kbinani/how-to-make-angel-ring-1/main.tex

\documentclass{ltjreport}
\usepackage{graphicx}
\usepackage{color}
\usepackage{siunitx}
\usepackage{hyperref}
\usepackage{attachfile2}
\usepackage{xcolor}
\usepackage[top=20mm,bottom=20mm,left=20mm,right=20mm]{geometry}
\usepackage{titlesec}
\usepackage{etoolbox}
\usepackage{chngcntr}
\usepackage[figure]{hypcap}
\usepackage[nogroupskip,section=none]{glossaries}

\makeatletter
\newcommand{\link}[2]{%
	\@ifundefined{r@#1}{%
		\textcolor{red}{#2 (\texttt{\detokenize{#1}})}%
	}{%
		\hyperref[#1]{#2}%
	}%
}
\makeatother

\newcommand{\asin}[1]{%
	\href{https://www.amazon.co.jp/dp/#1}{\texttt{ASIN:#1}}%
}

\renewcommand{\prechaptername}{}
\renewcommand{\postchaptername}{.}

\makeatletter
\patchcmd{\l@chapter}{4zw}{2zw}{}{}
\makeatother

\newcommand{\file}[2]{%
	\leavevmode
	\rlap{\textcolor{violet}{\texttt{#2}}}%
	\textattachfile{./attachment/#1}{\phantom{\texttt{#2}}}%
}

\newcommand{\img}[1]{%
	
}

\NewDocumentCommand{\defgls}{m m O{}}{%
	\newglossaryentry{#1}{name={#1},user1={#2},description={#3}}%
}

\newlength{\qindent}
\settowidth{\qindent}{\bfseries Q.\hspace{1em}}

\NewDocumentCommand{\qa}{+m +m}{%
	\paragraph{Q.}%
	\hangindent=\qindent
	\hangafter=1
	#1\par
	\vspace{-3.25ex}%
	\paragraph{A.}%
	\hangindent=\qindent
	\hangafter=1
	#2\par
}

\setcounter{secnumdepth}{3}
\counterwithout{figure}{chapter}

\defgls{クランプ}{\asin{B0D3TWFQYM}}
\defgls{真空槽}{\asin{B09QKQT76Z}}[BACOENG 製]
\defgls{中敷き}{\asin{B0D8BDKLCK}}
\defgls{エポキシ樹脂}{\asin{B09BJ2F91Y}}[デコレジーナ製「エポキシ樹脂 E384」]
\defgls{秤}{\asin{B072TBYM2K}}[タニタ製「クッキングスケール KJ-212 WH」]
\defgls{シリコーン樹脂マット}{\asin{B07KT39VH3}}
\defgls{攪拌棒}{\asin{B0DCJWFG8K}}
\defgls{プラスチックカップ}{\asin{B08F1Y5GFL}}
\defgls{色素}{\href{https://www.padico.co.jp/products/pigment-liquid/basic-colors/jewel-color-for-uv-and-uv-led-curing-resin-royal-blue/}{メーカー公式商品ページ}}[パジコ製「宝石の雫 ロイヤルブルー」]
\defgls{注射器}{\asin{B0BZ4GRGQX}}
\defgls{注射針(24G)}{\asin{B0CN4RSC4D}}
\defgls{注射針(20G)}{\asin{B0CMV9C128}}
\defgls{MDF 板材}{\asin{B0B6ZY4SFP}}
\defgls{3D プリンター}{\asin{B0F9DXZBW6}}[Creality 製「Ender3 V3 KE」]
\defgls{PLA}{\asin{B0C89KPYP3}}[Creality 製「Ender PLA フィラメント」]
\defgls{シリコーンチューブ}{\asin{B0DD7D93FN}}
\defgls{三叉バルブ}{\asin{B0DRCXKLVQ}}
\defgls{ホースニップル(G 1/4)}{\asin{B003FMS2Y6}}[SK11 製「ホースニップル外ネジ G(PF) 1/4 HG-1209 0200」]
\defgls{シールテープ}{\asin{B00VDTZMJQ}}[SK11 製「シールテープ SST-0805」]
\defgls{シリコーン樹脂}{\asin{B083QQJ2JS}}[旭化成ワッカーシリコーン製「ELASTOSIL(R) M8012」]
\defgls{両面テープ}{\asin{B07NPXBD1X}}[KAWAGUCHI 製「水に強い布用両面テープ」]
\defgls{マスキングテープ}{\asin{B009LALTUA}}[3M 製「マスキングテープ 243J Plus」]
\defgls{攪拌用ヘラ}{\asin{B019BWMXX4}}[貝印製「パレットナイフ」]
\defgls{シリコーンブロアー}{\asin{B0932Z7646}}[ハクバ製「シリコンブロアーポータブル 02 ブラック」]
\defgls{プラスチック板}{\asin{B00777S0A6}}[ツクワ製]
\defgls{パテ}{\asin{B000R9N5VU}}[タミヤ製「タミヤパテ(ホワイト) 87059」]
\defgls{レジンプリンター}{\asin{B0DT99F529}}[ELEGOO 製「Saturn 4 Ultra 16K」]
\defgls{レジン}{\asin{B0C61HMFMR}}[NOVA3D 製「水洗い高透明レジン」]
\defgls{コンパウンド}{\asin{B0CJJDTVS9}}[タミヤ製「タミヤコンパウンド 仕上げ目 87070」]
\defgls{バフ}{\asin{B0FPLD3NJ4}}
\defgls{ミニリューター}{\asin{B074WCD7VR}}[Dremel 製「ペン型ミニルーター FINO」]
\defgls{防毒マスク}{\asin{B0BJVBKJ6S}}[重松製作所製「取替え式防じんマスク・直結式小型防毒マスク」]
\defgls{有機ガス用吸収缶}{\asin{B072X8CW2M}}[重松製作所製「防じん機能付き吸収缶」]
\makenoidxglossaries

\newglossarystyle{items}{%
	\renewenvironment{theglossary}
		{\begin{longtable}[l]{lll}}
		{\hline\end{longtable}}%
	\renewcommand*{\glossaryheader}{%
		\hline
		品名 & 入手先 & メーカー等 \\ \hline
		\endhead
	}%
	\renewcommand*{\glsgroupheading}[1]{}%
	\renewcommand*{\glossentry}[2]{%
		\glstarget{##1}{\glossentryname{##1}} &
		\glsentryuseri{##1} &
		\glossentrydesc{##1} \\
	}%
	\renewcommand*{\glsgroupskip}{}%
}

\title{天使の輪っかのつくり方1 \\ [20mm]
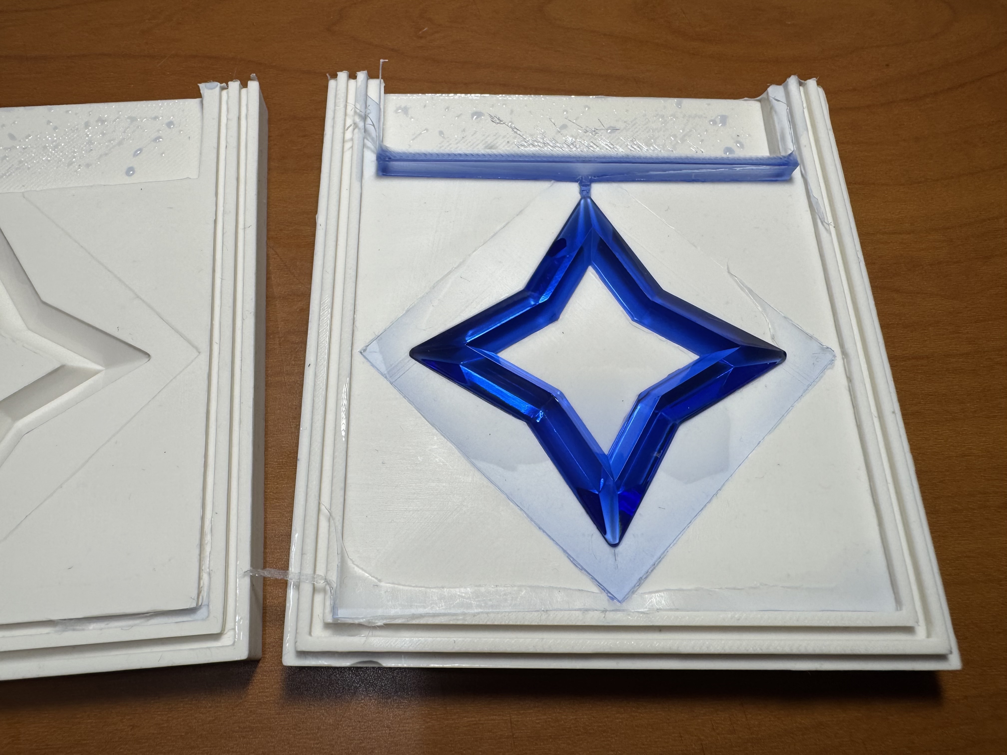
[picture p1: img/cover.jpeg]
 \\ [5mm]}
\author{kbinani}
\date{\today \\
\texttt{rev.2} \\
[2em]
\small 天使の輪っかのつくり方1 © 2026 by kbinani is licensed under CC BY-NC 4.0.
\\
To view a copy of this license, visit \href{https://creativecommons.org/licenses/by-nc/4.0/}{https://creativecommons.org/licenses/by-nc/4.0/}
\\
}

\hypersetup{ %
	colorlinks=true, %
	linkcolor=blue, %
	urlcolor=blue, %
	setpagesize=false, %
	bookmarks=true, %
	bookmarksdepth=tocdepth, %
	bookmarksnumbered=true %
}

\begin{document}
\maketitle

\chapter*{免責事項}

本冊子は著者の製作事例を紹介するものであり、手順の安全性、再現性および完成品の品質を保証するものではありません。

作業に際しては、使用する材料・機器の取扱説明書等を確認し、適切な安全対策を講じてください。

本冊子および添付データの利用によって生じた事故や損害について、著者は一切の責任を負いません。

\tableofcontents

\chapter{はじめに}

\noindent\textbf{本冊子について}\par
\vspace{0.5\baselineskip}
本冊子は、BOOTH に出品した「\href{https://kbinani.booth.pm/items/8443733}{(非公式)天音かなた・ミニチュア「天使の輪っか」エポキシ樹脂製・約5cm}」の製作手順を記したものである。
量産のための手順のみとし、開発過程は省略した。
「製作」の章は、最終仕上げを先頭に、製作のための治具製作などが後半となるよう、およそ時系列逆順に記した。
「Q\&A」の章には想定問答を記した。
最後の章には製作に必要な物品リストを掲載した。

\vspace{\baselineskip}

\noindent\textbf{添付ファイルについて}\par
\vspace{0.5\baselineskip}
本冊子の PDF にはファイルを埋め込んである。
紫色のファイル名の文字にはリンクが張ってあり、添付ファイルの取り出しに対応した PDF ビューワで閲覧するとファイルを取得できるようになっている。
Firefox と Acrobat Reader の場合は、どちらも紫色のリンクをダブルクリックすることでファイルを取得できる。

\chapter{製作}

%%%%%%%%%%%%%%%%%%%%%%%%%%%%%%%%%%%%%%%%%%%%%%%%%%%%%%%%%%%%%%%%%%%%%%%%%%%%%%%%%%
% 脱型と仕上げ
%%%%%%%%%%%%%%%%%%%%%%%%%%%%%%%%%%%%%%%%%%%%%%%%%%%%%%%%%%%%%%%%%%%%%%%%%%%%%%%%%%
\section{脱型と仕上げ}
\gls{エポキシ樹脂}の主剤と硬化剤を混合してから 72 時間以上経過後に脱型する。
\link{ln:runner}{ランナー部}分をカッターナイフで切り、\link{ln:mold}{型}の合わせ面部分に樹脂のはみ出しがあれば除去する。
表紙の図は脱型作業中の造形物の様子である。

%%%%%%%%%%%%%%%%%%%%%%%%%%%%%%%%%%%%%%%%%%%%%%%%%%%%%%%%%%%%%%%%%%%%%%%%%%%%%%%%%%
% 真空注型
%%%%%%%%%%%%%%%%%%%%%%%%%%%%%%%%%%%%%%%%%%%%%%%%%%%%%%%%%%%%%%%%%%%%%%%%%%%%%%%%%%
\section{真空注型}
\begin{enumerate}
	\item \link{ln:mold}{型}を準備する。
	\begin{enumerate}
		\item 型を清掃する。
		\item \link{ln:mold_spacer}{スペーサー}と\link{ln:mold}{型}を 2 枚の\link{ln:mold_shell}{押さえ板}で挟み、\gls{クランプ}で固定する。
			図\ref{fig:assembled_mold}に組み立てた型一式の様子を示す。
			\begin{figure}[htbp]
				\centering
				\img{./img/assembled_mold.jpeg}
				\caption{組み立てた型一式の様子}
				\label{fig:assembled_mold}
			\end{figure}
			\begin{itemize}
				\item 型と押さえ板の組み立て方について。
					\gls{真空槽}に複数の型一式を縦に積む場合に、上下の型一式の間に\gls{中敷き}を敷く。
					図\ref{fig:insole}に中敷きの配置例を示す。
					\begin{figure}[htbp]
						\centering
						\img{./img/insole.jpeg}
						\caption{中敷きを下段の型一式の上に設置した様子}
						\label{fig:insole}
					\end{figure}
					下段に置く型は、型の上面を下にして組み立て作業を行う。
					上段に置く型は下面を下にして組み立て作業を行う。
					中敷きに当たる側の面が揃っていたほうが、中敷きが安定するからである。
				\item クランプの締め付けは程々にする。
					具体的には、組み立てた型を手で持った時、型内部の空洞の容積がほぼ変化しない程度の強さでクランプする。
					型内部の空洞の容積が変化すると\link{ln:boiling_tank}{沸騰槽}と型内部で樹脂の移動が起こり、意図しない気泡の巻き込みが起こりやすくなるからである。
					\link{ln:deforming}{脱泡}の操作が台無しになる。
					またクランプの締め付けが強すぎると、型表面の肌が変形し品質を損なう。
			\end{itemize}
	\end{enumerate}
	\item 真空ポンプを準備する。
	\begin{itemize}
		\item 真空ポンプの取扱説明書に従う。
		\item 特に、オイル量が適切か確認する。
	\end{itemize}
	\item 真空槽を準備する。
	\begin{enumerate}
		\item 空気圧ゲージを準備する。
		\begin{itemize}
			\item 空気圧ゲージの取扱説明書に従う。
			\item オイル封入型の場合内圧を大気圧と一致させる為のプラグが付いているので、忘れずに操作する。
		\end{itemize}
		\item 真空槽の大気側プラグに\link{ln:mold_capillary}{キャピラリ}を取り付ける。
			キャピラリの全てのバルブを全閉にする。
		\item 真空槽の真空ポンプ側プラグと真空ポンプを接続する。
			真空槽の全てのバルブを全閉にする。
	\end{enumerate}
	\item \gls{エポキシ樹脂}を準備する。
	\begin{enumerate}
		\item \gls{秤}を\gls{シリコーン樹脂マット}の上に設置する。
		\item \gls{防毒マスク}に\gls{有機ガス用吸収缶}を取り付け、装備する。
		\item \gls{攪拌棒}と\gls{プラスチックカップ}を清掃する。
		\item プラスチックカップの風袋を量る。
		\item プラスチックカップにエポキシ樹脂の主剤を所定の量量り取る。
		\begin{itemize}
			\item 注型する型の個数 $ \times $ 5.9g の主剤を用いる。
		\end{itemize}
		\item プラスチックカップに\gls{色素}を投入する。
		\begin{itemize}
			\item 主剤 1.0 g に対して 1.0 滴の色素を用いる。
		\end{itemize}
		\item プラスチックカップにエポキシ樹脂の硬化剤を投入する。
		\begin{itemize}
			\item 主剤重量の 40\% の硬化剤を投入する。
		\end{itemize}
		\item 攪拌棒を用いて撹拌する。
		\begin{itemize}
			\item 3 分程度撹拌する。
			\item 撹拌中、気泡が入っても問題ない。
				真空引きしたとき結局発泡するので、撹拌時点で混入する気泡は気にする必要ない。
		\end{itemize}
	\end{enumerate}
	\item 型の沸騰槽に樹脂を入れる。
	\begin{itemize}
		\item \gls{注射器}を用いて 6mL 量る。
	\end{itemize}
	\item 型一式を真空槽に仕込む。
	\begin{itemize}
		\item 上下に 2 段積む場合、上下段の間に中敷きを入れる。
	\end{itemize}
	\item 真空注型を行う。
	\begin{enumerate}
		\item 真空槽の蓋のパッキン部分を清掃し、真空槽に設置する。
		\item 真空ポンプのオイル量と、真空槽の真空ポンプ側バルブが全閉になっている事を確認し、真空ポンプを稼働させる。
		\item 真空槽の真空ポンプ側バルブを全開にする。
		\item 真空槽の蓋を押さえつけて気密する。
		\item ストップウォッチで計時開始する。
		\item 空気圧ゲージがゲージ圧で -1.0 bar となるか、または 3 分経過するまで待機する。
		\item キャピラリの 2 つのバルブがどちらも全閉になっている事を確認し、真空槽の大気側バルブを全開にする。
		\begin{itemize}
			\item この操作はキャピラリ内圧と真空槽内圧を等しくするためのもの。
		\end{itemize}
		\item 真空槽の真空ポンプ側バルブを全閉にする。
		\item 真空ポンプを停止する。
		\item キャピラリの\gls{注射針(24G)}が付いている側のバルブを全開にする。
		\item 空気圧ゲージがゲージ圧で -0.7 bar となるまで待機する。
		\item 真空槽の大気側バルブを全閉にする。
		\item キャピラリの注射針が付いている側のバルブを全閉にする。
		\item キャピラリの注射針が付いていない側のバルブを全開にする。
		\item 真空槽の大気側バルブを少しだけ開き、槽内を大気圧まで戻す。
		\begin{itemize}
			\item -0.7 bar から 2 分程度で大気圧まで戻す。
				速すぎると槽内が結露するので結露しない程度の速度であればよい。
		\end{itemize}
		\item 操作したバルブを全て全閉に戻す。
	\end{enumerate}
	\item 脱泡を行う。\label{ln:deforming}

	この操作は、型の上部に引き込まれた気泡を取り除くために行う。
	\begin{figure}[htbp]
		\centering
		\img{./img/bubble.jpeg}
		\caption{脱泡処理を行わなかった場合のランナー部周辺の様子}
		\label{fig:bubble}
	\end{figure}
	この脱泡操作を行わなかった場合の造形結果を図\ref{fig:bubble}に示す。
	本作品の形状の場合、毎回図のような位置に気泡が留まりそのまま硬化してしまうようだ。
	本操作では、ランナー部から注射器を用いて樹脂を注入し、気泡を型の外に押し出す。
	\begin{enumerate}
		\item 真空槽から型一式を取り出す。
		\item プラスチックカップに残っている樹脂を注射器に 1mL 吸い込み、\gls{注射針(20G)}を取り付ける。
			このとき気泡が入らないように充分注意する。
		\item 注射器の押し子を少し押し、注射針の中の気泡を排出する。
		\item 型の沸騰槽の底に開いているランナー部分の穴に注射針を 1cm 程度挿入し、樹脂を注入する。
		\begin{itemize}
			\item 注射針先端の位置が気泡より下になっていればよい。
				気泡より上の位置で樹脂を注入しても気泡は上がってこない。
			\item 医療用の注射針を使うと型を刺して破損するので、工業用の先が平らなものを使用する。
			\item 1mL を 5 秒程度の速度で注入する。
			\item 注射器が空になるまで注入せず、少し手前で止める。
				1mL を全て注入すると、押し子のガスケットに付着している気泡を型内部に注入してしまうからである。
			\item 注入する操作の過程で、ランナー部分から気泡が上がってくるのでよく観察する。
				通常この操作は 1 回だけで充分だが、注入操作の終盤になっても気泡がまだ上がってくるようなら、何らか操作が失敗して気泡が想定より多く混入している。
				リカバリのため、投機的にはなってしまうが、この脱泡の操作を気泡が上がってこなくなるまで繰り返すとよいかもしれない。
		\end{itemize}
	\end{enumerate}
	\item 型を静置する。
	\begin{itemize}
		\item 直射日光が当たらず、振動が少なく、温度の安定した場所で保管する。
	\end{itemize}
\end{enumerate}

%%%%%%%%%%%%%%%%%%%%%%%%%%%%%%%%%%%%%%%%%%%%%%%%%%%%%%%%%%%%%%%%%%%%%%%%%%%%%%%%%%
% 型
%%%%%%%%%%%%%%%%%%%%%%%%%%%%%%%%%%%%%%%%%%%%%%%%%%%%%%%%%%%%%%%%%%%%%%%%%%%%%%%%%%
\section{型}\label{ln:mold}

\begin{figure}[htbp]
	\centering
	\img{./img/mold.jpeg}
	\caption{型の外観}
	\label{fig:mold}
\end{figure}

\begin{figure}[htbp]
	\centering
	\img{./img/mold_description.jpeg}
	\caption{型各部の呼称}
	\label{fig:mold_description}
	\label{ln:boiling_tank}
	\label{ln:runner}
\end{figure}

図\ref{fig:mold}に型の外観を示す。
また型各部の呼称を図\ref{fig:mold_description}に示す。
\gls{シリコーン樹脂}で製作する。
型は 2 個一組で組み立てて使用する。
2 個の型は、同一の\link{ln:prototype}{原型}を用いて製作し、パッキン部の凹凸のみが異なる。
組み立てた型には\link{ln:boiling_tank}{沸騰槽}があり、沸騰槽の底はすり鉢状となっている。
沸騰槽の底には、ランナーとなる穴が一つ開いており型の空洞部と繋がっている。

以下の手順で製作する。

\begin{enumerate}
	\item \link{ln:mold_holder}{原型ホルダー}を清掃し、原型を嵌め込む。
	原型の基準面は、原型ホルダーの基準面よりわずかに埋まった位置で固定する。
	これにより、製作した型は原型周辺が僅かに盛り上がった形状となり、\gls{クランプ}した時力が掛かりやすくなる。
	造形物の周囲に生じる\gls{エポキシ樹脂}の膜を非常に薄くすることができる。
	\item 原型ホルダーのパッキン部を造形するための溝に、\link{ln:mold-holder-gasket-jig}{パッキン溝造形用治具}を装着する。
		パッキン部が凸のものを造形する時は、この手順は省略する。
	\item 原型ホルダーに\link{ln:mold-holder-frame}{枠}を装着する。
	\item \link{ln:mold-resevoir}{沸騰槽造形用治具}の底面に\gls{両面テープ}と\gls{マスキングテープ}を貼る。
	\begin{itemize}
		\item マスキングテープは、両面テープの厚み分の隙間を埋めるために貼る。
		シリコーン樹脂が隙間に侵入するのを防ぐためである。
		図\ref{fig:resevoir_back}に両面テープとマスキングテープの貼り付け例を示す。
		\begin{figure}[htbp]
			\centering
			\img{./img/resevoir_back.jpeg}
			\caption{沸騰槽造形用治具の裏に両面テープをマスキングテープを貼り付けた様子}
			\label{fig:resevoir_back}
		\end{figure}
	\end{itemize}
	\item 沸騰槽造形用治具を原型ホルダーに接着する。
	\item 原型ホルダー一式を清掃する。
	\item \gls{秤}を\gls{シリコーン樹脂マット}の上に設置する。
	\item \gls{攪拌用ヘラ}と\gls{プラスチックカップ}を清掃する。
	\item プラスチックカップの風袋を量る。
	\item シリコーン樹脂主剤をプラスチックカップに所定の量量り取る。
	\begin{itemize}
		\item パッキン部が凸のものを造形する場合は 127.5g、凹のものを造形する時は 120.7g を量り取る。
	\end{itemize}
	\item シリコーン樹脂硬化剤を所定の量投入し 3 分程度混合する。
	\begin{itemize}
		\item 量り取った主剤の重量の 3\% の硬化剤を投入する。
		\item 硬化剤を投入直後から硬化が進む。以降の作業は 20 分程度で完了する必要がある。
	\end{itemize}
	\item 適当なベニア板製の作業台の上に新聞紙を敷き、原型ホルダー一式を置く。
		この作業台は、硬化させる間の保管場所に移動させるためのものなので目的を達せられれば材質は何でもよい。
	\item 原型の輪っか部分全体を薄く覆う程度に、シリコーン樹脂液を注ぐ。
	\item \gls{シリコーンブロアー}を用いて原型表面のシリコーン樹脂液に空気を吹き付け、原型に付着している微小な気泡を除去する(図\ref{fig:bubble-removal})。
	\begin{itemize}
		\item 気泡が残ったままシリコーン樹脂が硬化すると、型を用いて造形した際小さな突起として現れ品質を損なう。
			従って気泡の除去処理は、原型の表面処理と同程度に重要である。
		\item 樹脂液を薄膜にすることにより、微小な気泡が崩壊しやすくなる。
			空気を吹き付けた箇所をよく観察していると、気泡が弾ける瞬間を見ることができる。
		\item 空気を吹き付ける方法の代わりに、樹脂液を刷毛で塗って薄膜を作る方法もある。
			洗い物が増えるので、本作品程度の大きさなら空気を吹き付ける方法の方が効率が良い。
	\end{itemize}
	\begin{figure}[htbp]
		\centering
		\img{./img/bubble-removal.jpeg}
		\caption{気泡除去を行った直後の様子}
		\label{fig:bubble-removal}
	\end{figure}
	\item 残りのシリコーン樹脂液を、枠の上面を超えるまで注ぐ。
	\item \gls{プラスチック板}表面を清掃し、シリコーン樹脂液面に被せる。
	\begin{itemize}
		\item プラスチック板は PET 製のものを用いる。塩ビ製のものは、シリコーン樹脂が固着することがある。
	\end{itemize}
	\item 硬化させるための保管場所の水平度を確認する。
		傾いていると、枠からはみ出した樹脂が新聞紙の範囲を越えて周囲を汚染する可能性がある。
		肉眼で見て分からないほどゆっくり流動するので注意が必要。
	\item 作業台一式を、硬化させるための保管場所に移動する。
	\item プラスチック板の上に本を置き、その上に重りを載せる。
		本は、枠より大判でハードカバーのものを用いる。
		プラスチック板がたわまないようにするためである。
		重りは、枠とプラスチック板が接触するまで余剰のシリコーン樹脂液を押し出すために設置する。
	\item シリコーン樹脂が硬化するまで静置する。目安は 12 時間程度。
	\item 原型ホルダーから型を取り出す前に、可能な範囲でバリを取り除く。
	\begin{itemize}
		\item 硬化したシリコーン樹脂はプリプリしていて刃物が入りづらく、バリの除去が非常に面倒。
			原型ホルダーから外す前の状態の方がバリ取り作業しやすいので、外す前に可能な範囲でバリ取り作業を行っておく。
	\end{itemize}
	\item 硬化した型を原型ホルダーから取り外す。
	\item カッターナイフや彫刻刀を用いて、残っているバリを取り除く。
	\begin{itemize}
		\item 沸騰槽底のランナー部分は、バリの形状を観察してあえてバリ取りしない事がある。
			バリが僧帽弁のようになっているもののランナー穴は貫通している場合、その方がランナー部を細く造形できる。
			エポキシ樹脂で造形した時ランナー部が細い方が切り取り痕が小さくなるため都合が良い。
	\end{itemize}
\end{enumerate}

%%%%%%%%%%%%%%%%%%%%%%%%%%%%%%%%%%%%%%%%%%%%%%%%%%%%%%%%%%%%%%%%%%%%%%%%%%%%%%%%%%
% 原型
%%%%%%%%%%%%%%%%%%%%%%%%%%%%%%%%%%%%%%%%%%%%%%%%%%%%%%%%%%%%%%%%%%%%%%%%%%%%%%%%%%
\section{原型}\label{ln:prototype}

\begin{figure}[htbp]
	\centering
	\img{./img/prototype.jpeg}
	\caption{原型}
	\label{fig:prototype}
\end{figure}

図\ref{fig:prototype}に原型の外観を示す。
\gls{レジンプリンター}を用いて製作する。

\gls{レジン}は透明なものを使用する。
透明な素材とすることで、表面の透過と反射の具合から仕上げの状態を判断できる。
原型の表面仕上の品質が、ほぼそのまま造形物に反映されるから、表面は研磨して鏡面仕上げとする。

以下の手順で製作する。

\begin{enumerate}
	\item \gls{レジンプリンター}で造形する。形状はこちら: \file{prototype.stl}{prototype.stl}
	\item 原型の台の部分を\link{ln:mold_holder}{原型ホルダー}に嵌め込めるよう、所定のサイズになるまで紙やすりで削る。
		原型ホルダーより、原型の台の部分を削る方が削りやすいので、原型ホルダーの現物に合わせて原型の方を削る。
		原型ホルダーに原型を嵌め込んだ時固く保持できるよう、削り過ぎに注意する。
	\item 原型の天使の輪っか部分の表面を耐水ペーパーで研磨する。
		耐水ペーパーの番手を 1000、1500、2000、3000 の順番で上げる。各番手は、以下の手順で研磨する。
	\begin{enumerate}
		\item 研磨する部分を油性マジックで塗りつぶす(図\ref{fig:marking_for_sanding})。
		\item 油性マジックの塗り色が消えるまで研磨する。
	\end{enumerate}
	\begin{figure}[htbp]
		\centering
		\img{./img/marking_for_sanding.jpeg}
		\caption{研磨する部分に油性マジックでマーキングを施した様子}
		\label{fig:marking_for_sanding}
	\end{figure}
	原型が小さいので、耐水ペーパーを小さく切って\link{ln:sanding_paper_holder}{耐水ペーパーホルダー}に貼り付けると作業し易くなる。
	\item 鏡面仕上げにする。
		\gls{コンパウンド}を\gls{バフ}に塗り、\gls{ミニリューター}で研磨する。
\end{enumerate}

%%%%%%%%%%%%%%%%%%%%%%%%%%%%%%%%%%%%%%%%%%%%%%%%%%%%%%%%%%%%%%%%%%%%%%%%%%%%%%%%%%
% 耐水ペーパーホルダー
%%%%%%%%%%%%%%%%%%%%%%%%%%%%%%%%%%%%%%%%%%%%%%%%%%%%%%%%%%%%%%%%%%%%%%%%%%%%%%%%%%
\section{耐水ペーパーホルダー}\label{ln:sanding_paper_holder}
小さい物品を耐水ペーパーで研磨する際、耐水ペーパーの面の向きを細かく制御できるようにするために用いる。

形状はこちら: \file{sanding-paper-holder.stl}{sanding-paper-holder.stl}。
\gls{3D プリンター}を用いて\gls{PLA}で製作する。
台形となっている部分の底面に、幅をホルダーの幅、長さを 10mm 程度に切った耐水ペーパーを\gls{両面テープ}で貼り付けて使用する。
台形のテーパ部分は、研磨対象の谷になっている部分の隅まで耐水ペーパーを当てられるようにするために設けてある。
図\ref{fig:sanding_paper_holder}に耐水ペーパーの貼付け例を示す。
\begin{figure}[htbp]
	\centering
	\img{./img/sanding_paper_holder.jpeg}
	\caption{耐水ペーパーホルダーに耐水ペーパーを貼り付けた様子}
	\label{fig:sanding_paper_holder}
\end{figure}

%%%%%%%%%%%%%%%%%%%%%%%%%%%%%%%%%%%%%%%%%%%%%%%%%%%%%%%%%%%%%%%%%%%%%%%%%%%%%%%%%%
% 原型ホルダー
%%%%%%%%%%%%%%%%%%%%%%%%%%%%%%%%%%%%%%%%%%%%%%%%%%%%%%%%%%%%%%%%%%%%%%%%%%%%%%%%%%
\section{原型ホルダー}\label{ln:mold_holder}
\gls{3D プリンター}を用いて\gls{PLA}で製作する。
基準面は積層痕の凹凸を減らすため\gls{パテ}を塗り、乾燥後 400 番の耐水ペーパーで仕上げる。
この仕上げを省略すると、\gls{エポキシ樹脂}を造形した時樹脂が細かい凹凸に入り込み脱型と清掃が面倒になる。
原型ホルダーの仕上げ処理は 1 回だが、エポキシ樹脂の脱型と清掃は毎回のことなので仕上げには手間を掛けるべき。

形状はこちら: \file{mold-holder.stl}{mold-holder.stl}

%%%%%%%%%%%%%%%%%%%%%%%%%%%%%%%%%%%%%%%%%%%%%%%%%%%%%%%%%%%%%%%%%%%%%%%%%%%%%%%%%%
% パッキン溝造形用治具
%%%%%%%%%%%%%%%%%%%%%%%%%%%%%%%%%%%%%%%%%%%%%%%%%%%%%%%%%%%%%%%%%%%%%%%%%%%%%%%%%%
\section{パッキン溝造形用治具}\label{ln:mold-holder-gasket-jig}
\gls{3D プリンター}を用いて\gls{PLA}で製作する。

形状はこちら: \file{mold-holder-gasket-jig.stl}{mold-holder-gasket-jig.stl}

%%%%%%%%%%%%%%%%%%%%%%%%%%%%%%%%%%%%%%%%%%%%%%%%%%%%%%%%%%%%%%%%%%%%%%%%%%%%%%%%%%
% 沸騰槽造形用治具
%%%%%%%%%%%%%%%%%%%%%%%%%%%%%%%%%%%%%%%%%%%%%%%%%%%%%%%%%%%%%%%%%%%%%%%%%%%%%%%%%%
\section{沸騰槽造形用治具}\label{ln:mold-resevoir}
\gls{3D プリンター}を用いて\gls{PLA}で製作する。

形状はこちら: \file{mold-holder-resevoir-jig.stl}{mold-holder-resevoir-jig.stl}

%%%%%%%%%%%%%%%%%%%%%%%%%%%%%%%%%%%%%%%%%%%%%%%%%%%%%%%%%%%%%%%%%%%%%%%%%%%%%%%%%%
% 枠
%%%%%%%%%%%%%%%%%%%%%%%%%%%%%%%%%%%%%%%%%%%%%%%%%%%%%%%%%%%%%%%%%%%%%%%%%%%%%%%%%%
\section{枠}\label{ln:mold-holder-frame}
\gls{3D プリンター}を用いて\gls{PLA}で製作する。

形状はこちら: \file{mold-holder-frame.stl}{mold-holder-frame.stl}

%%%%%%%%%%%%%%%%%%%%%%%%%%%%%%%%%%%%%%%%%%%%%%%%%%%%%%%%%%%%%%%%%%%%%%%%%%%%%%%%%%
% スペーサー
%%%%%%%%%%%%%%%%%%%%%%%%%%%%%%%%%%%%%%%%%%%%%%%%%%%%%%%%%%%%%%%%%%%%%%%%%%%%%%%%%%
\section{スペーサー}\label{ln:mold_spacer}

\begin{figure}[htbp]
	\centering
	\img{./img/mold_spacer.jpeg}
	\caption{スペーサー}
	\label{fig:mold_spacer}
\end{figure}

図\ref{fig:mold_spacer}にスペーサーの外観を示す。
\link{ln:mold}{型}を\link{ln:mold_shell}{押さえ板}で挟み固定するとき、型が圧縮される量を制限するためのもの。
型 1 個につき 2 個製作する。
形状は幅 10mm、高さ 112mm とする。
厚みについては、製作した型を組み立てて厚みを計測し、その厚みより 0.2mm 薄くする。
\gls{3D プリンター}で\gls{PLA}で制作する。

形状の例はこちら: \file{mold-spacer.stl}{mold-spacer.stl}

%%%%%%%%%%%%%%%%%%%%%%%%%%%%%%%%%%%%%%%%%%%%%%%%%%%%%%%%%%%%%%%%%%%%%%%%%%%%%%%%%%
% 押さえ板
%%%%%%%%%%%%%%%%%%%%%%%%%%%%%%%%%%%%%%%%%%%%%%%%%%%%%%%%%%%%%%%%%%%%%%%%%%%%%%%%%%
\section{押さえ板}\label{ln:mold_shell}

\begin{figure}[htbp]
	\centering
	\img{./img/mold_shell.jpeg}
	\caption{押さえ板}
	\label{fig:mold_shell}
\end{figure}

図\ref{fig:mold_shell}に押さえ板の外観を示す。
厚さ 12mm の \gls{MDF 板材}を 123mm $ \times $ 112mm に切断する。
\link{ln:mold}{型} 1 個あたり 2 枚製作する。

%%%%%%%%%%%%%%%%%%%%%%%%%%%%%%%%%%%%%%%%%%%%%%%%%%%%%%%%%%%%%%%%%%%%%%%%%%%%%%%%%%
% キャピラリ
%%%%%%%%%%%%%%%%%%%%%%%%%%%%%%%%%%%%%%%%%%%%%%%%%%%%%%%%%%%%%%%%%%%%%%%%%%%%%%%%%%
\section{キャピラリ}\label{ln:mold_capillary}

\begin{figure}[htbp]
	\centering
	\img{./img/capillary.jpeg}
	\caption{キャピラリ}
	\label{fig:capillary}
\end{figure}

\gls{真空槽}に流入する空気の流量を抑制し、注型作業の再現性を高めるために用いる。
真空注型は、真空から大気圧に戻す際のごく序盤でほとんどの樹脂が型の空洞部に流れ込むため、序盤の圧力制御は非常に重要である。
真空槽に付属のボールバルブを手動で操作する場合、流量の細かな制御が難しく再現性が低い。
キャピラリを用いることで、バルブの操作は全開/全閉を行うだけで充分な再現性が得られる。

以下の手順で製作する。

\begin{enumerate}
	\item $ \phi $10mm の\gls{シリコーンチューブ}を 75mm の長さに切断する。
		\gls{三叉バルブ}とキャピラリ本体を接続するのに用いる。
	\item $ \phi $10mm のシリコーンチューブを 50mm の長さに切断する。
		三叉バルブと真空槽の大気側プラグを接続するのに用いる。
	\item \gls{注射器}に\gls{注射針(24G)}を取り付ける。
		押し子は使用しない。
	\item 前述の長さ 75mm のシリコーンチューブを、前述の注射器のルアーロック部分に被せる。
		もう一方のチューブ端を三叉バルブのバルブが付いているプラグどちらかに接続する(図\ref{fig:capillary})。
	\item 真空槽の大気側プラグに付属しているフィルタを撤去する。
	\item \gls{ホースニップル(G 1/4)}の雄ねじに\gls{シールテープ}を巻き、真空槽の大気側雌ねじに装着する。
	\item 三叉バルブのバルブが付いていないプラグと、前述のホースニップル(G 1/4)と、を前述の長さ 50mm のシリコーンチューブを使って接続する。
		真空槽を片付ける時は、こちらのシリコーンチューブの、三叉バルブ側の端を三叉バルブから外す。
\end{enumerate}

\chapter{Q\&A}

\qa
{\link{ln:mold}{型}の材質はワッカーシリコーン M8012 以外だとだめなのか。}
{ワッカーシリコーン M4470、M4503、M8012 を試した。
	他の種類は分からない。
	この三種はいずれも本作品の型として利用できると思う。
	M8012 と比較して M4470 は少々硬くやや高価、M4503 は同程度の硬さで引張強度が強いが高価。
	M4503 の引張強度は本作品の型として使うにはオーバースペックだと感じる。
	安価で程よい柔らかさの M8012 を継続して使用している。}

\qa
{\link{ln:mold_holder}{原型ホルダー}のパッキンが二重になっているが、一重としていない理由は。}
{念のため二重にして充分だったのでそのまま使っている。
	脱型した後の樹脂で濡れた痕跡の範囲を見る限り、一重でも充分そうだという判断。
	パッキンを無しにするのは試してみないと分からないが、漏れそうな予感がする。}

\qa
{\gls{レジンプリンター}のプリント設定は。}
{以下の通り:\\
\\
\begin{tabular}{llS[table-format=2.2]@{\,}l}
	層厚さ & & 0.01 & mm \\
	\hline
	初期層 & 層数 & 5 & \\
		& 遷移層の数 & 4 & \\
		& 露光時間 & 5 & 秒 \\
		& 養生前に待機 & 40 & 秒 \\
		& リリース前に待機 & 12 & 秒 \\
		& リリース後に待機 & 0 & \\
	\hline
	通常層 & 露光時間 & 1.8 & 秒 \\
		& 養生前に待機 & 3 & 秒 \\
		& リリース前に待機 & 0.5 & 秒 \\
		& リリース後に待機 & 0 & \\
	\hline
	アンチエイリアス & & \multicolumn{2}{l}{無効} \\
	印刷速度 & & \multicolumn{2}{l}{標準} \\
	レジン加熱 & & \multicolumn{2}{l}{あり} \\
\end{tabular}}

\qa
{\link{ln:deforming}{脱泡}の操作で使用している\gls{注射器}の選定理由は。}
{シリンジの断面積が小さく、高粘度の液に対して細い針を使っていても小さい力で操作できることから。
	樹脂を注入する時、注射針がすっぽ抜ける事故を度々起こしたのでルアーロック付きのものを使っている。
	ルアーロック付きであれば、より太い注射器でも問題ないと思う(握力は必要)。}

\qa
{\gls{エポキシ樹脂}の種類は他のものは試したか。}
{試していない。}

\qa
{\link{ln:mold_spacer}{スペーサー}の製作で型の厚みより 0.2mm 薄くするとあるが、0.2mm の理由は。}
{経験則。
	隙間から樹脂が漏れないようにするために必要なクランプ力を維持しつつ、型の変形を最小限に抑えたい、という考え方で試行錯誤して決めた量。
	0.2mm としているが、型の厚みを増やし、クランプ時の圧縮量を減らすのが理想だと思う。}

\qa
{\link{ln:prototype}{原型}の台と輪っか部分の境目は谷になっている。
	この部分の研磨はどうやっているのか。}
{谷の部分の細かい所は研磨できていない。
	なるべく耐水ペーパーやバフが当たるようにはしたが、厳密には台と輪っかの境目は研磨できていない。
\link{ln:mold}{型}の貼り合わせ部分となってバリの出る箇所なので、厳重に研磨しても無駄かなと考えている。}

\chapter{調達}
\printnoidxglossary[style=items,sort=use]

\end{document}
