kbinani/how-to-make-angel-ring-1/img/bubble-removal.jpeg

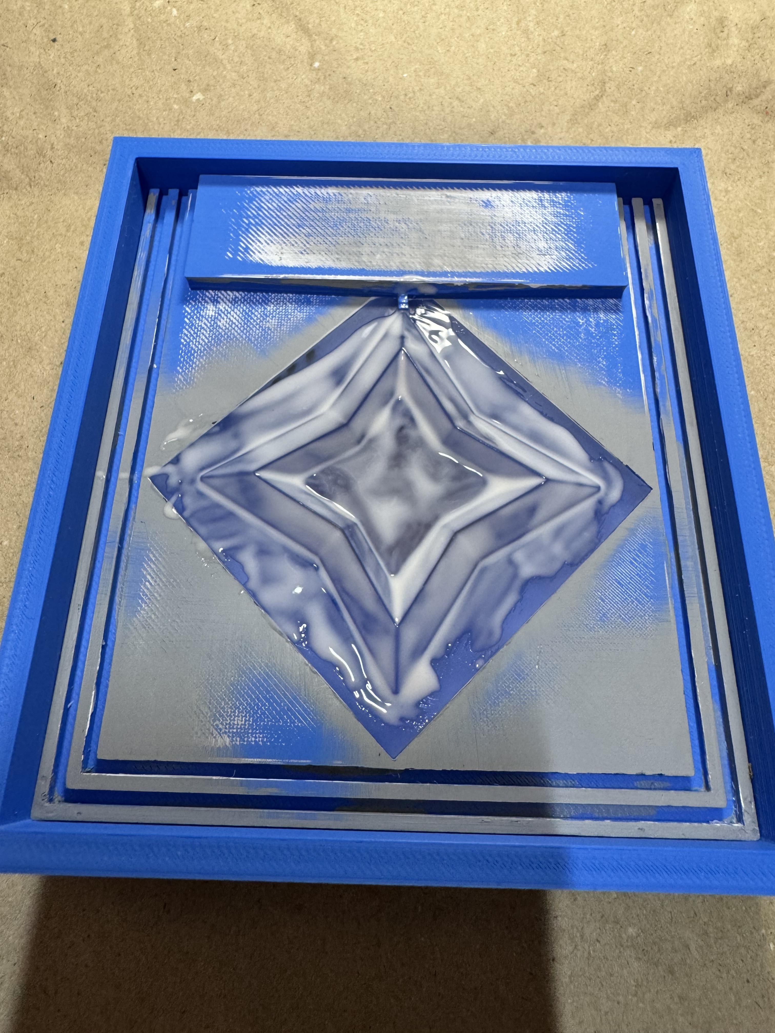
img/bubble-removal.jpeg
