kbinani/how-to-make-angel-ring-1/img/bubble.jpeg

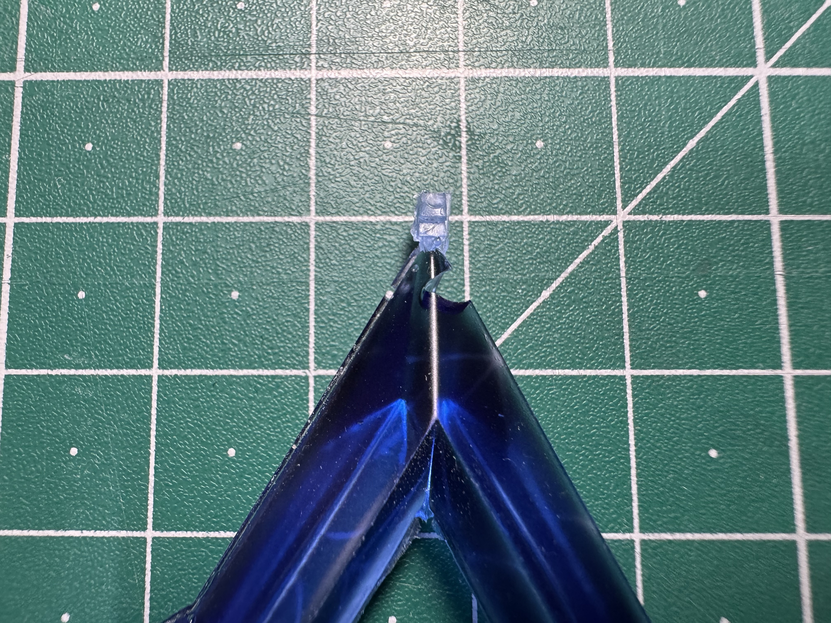
img/bubble.jpeg
