kbinani/how-to-make-angel-ring-1/img/capillary.jpeg

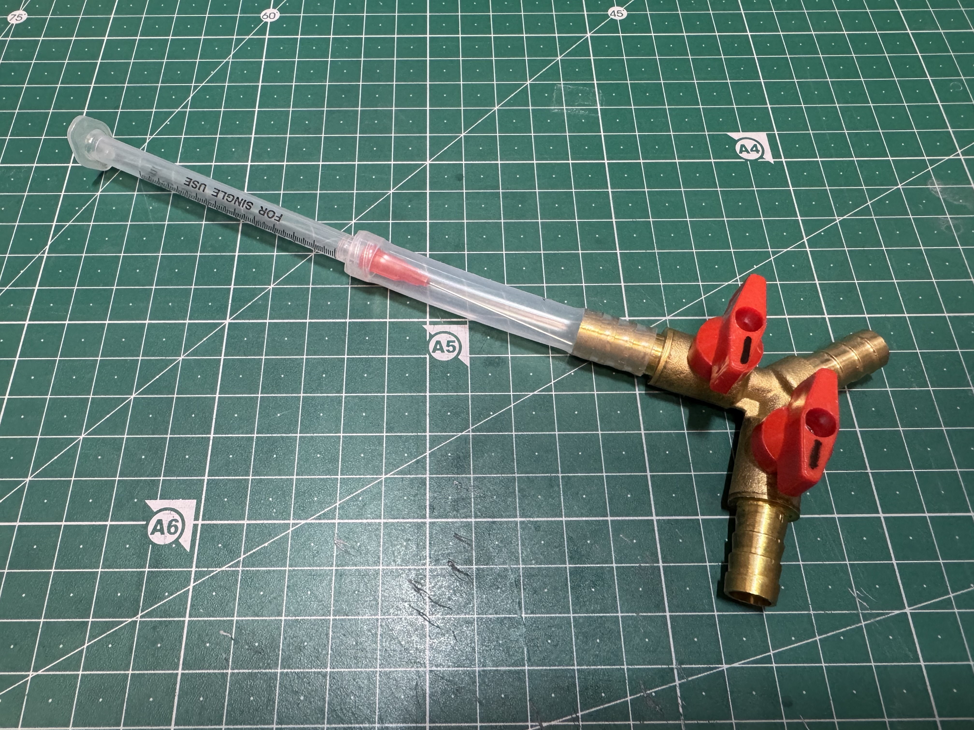
img/capillary.jpeg
