kbinani/how-to-make-angel-ring-1/img/insole.jpeg

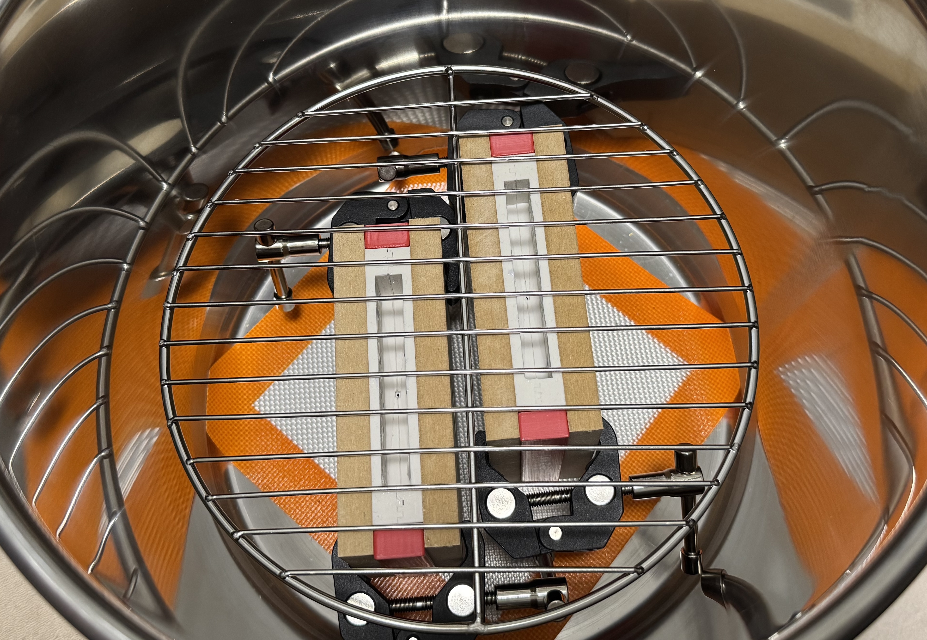
img/insole.jpeg
