kbinani/how-to-make-angel-ring-1/img/marking_for_sanding.jpeg

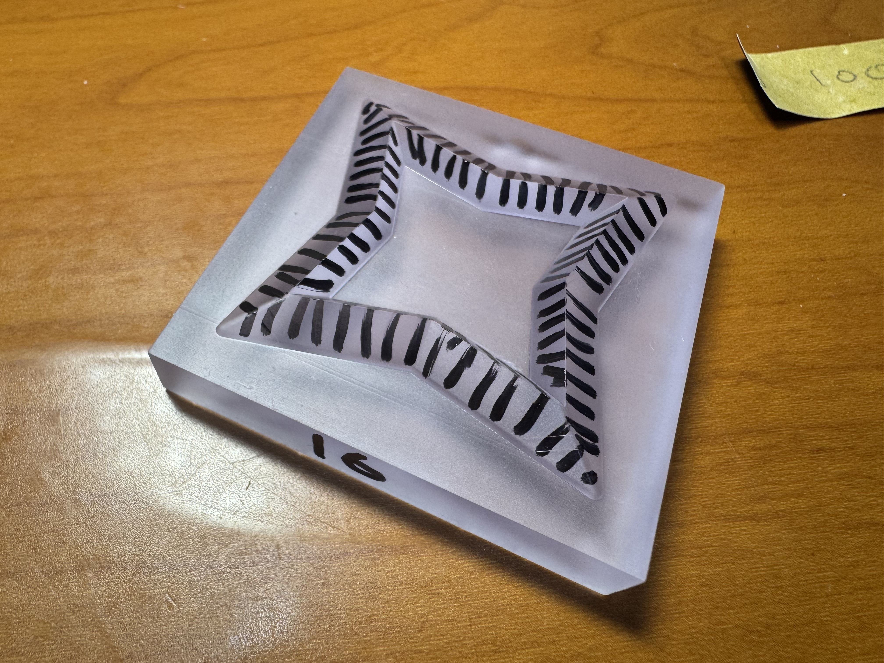
img/marking_for_sanding.jpeg
