kbinani/how-to-make-angel-ring-1/img/mold.jpeg

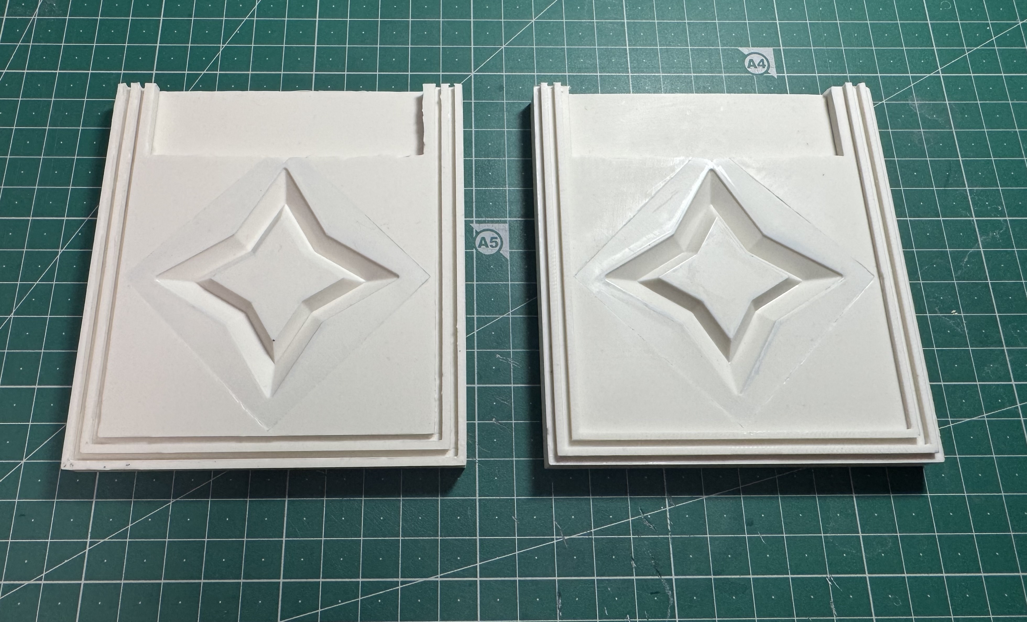
img/mold.jpeg
