kbinani/how-to-make-angel-ring-1/img/mold_shell.jpeg

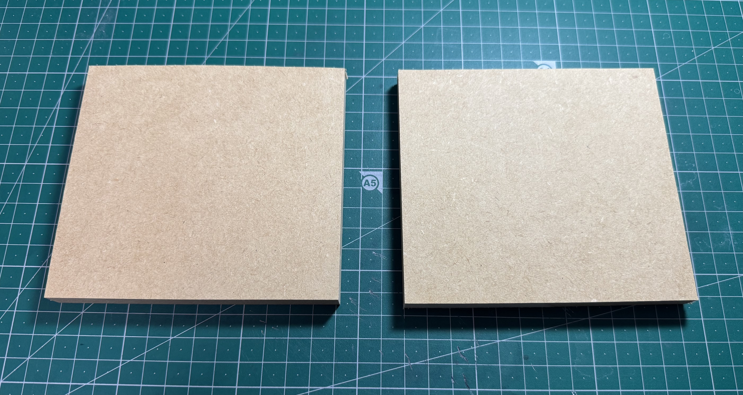
img/mold_shell.jpeg
