kbinani/how-to-make-angel-ring-1/img/mold_spacer.jpeg

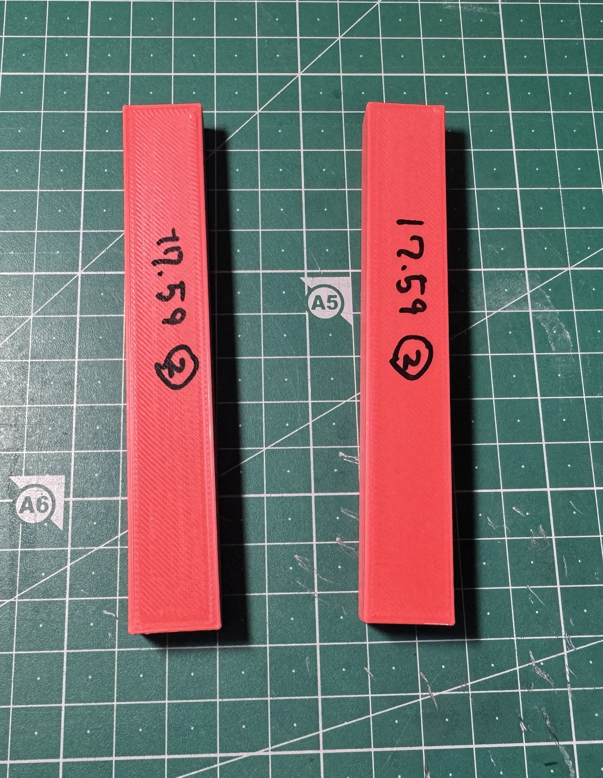
img/mold_spacer.jpeg
