kbinani/how-to-make-angel-ring-1/img/prototype.jpeg

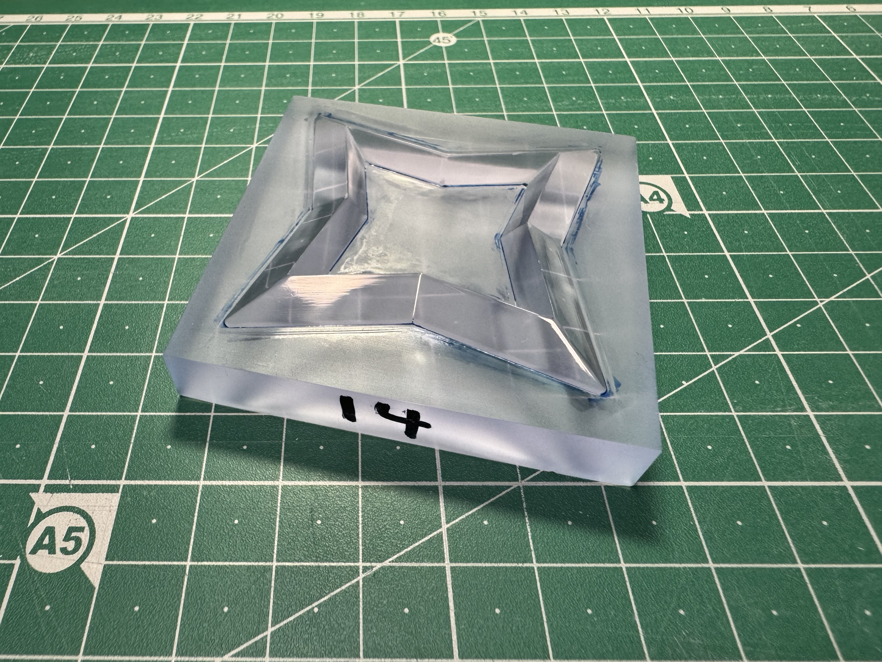
img/prototype.jpeg
