kbinani/how-to-make-angel-ring-1/img/resevoir_back.jpeg

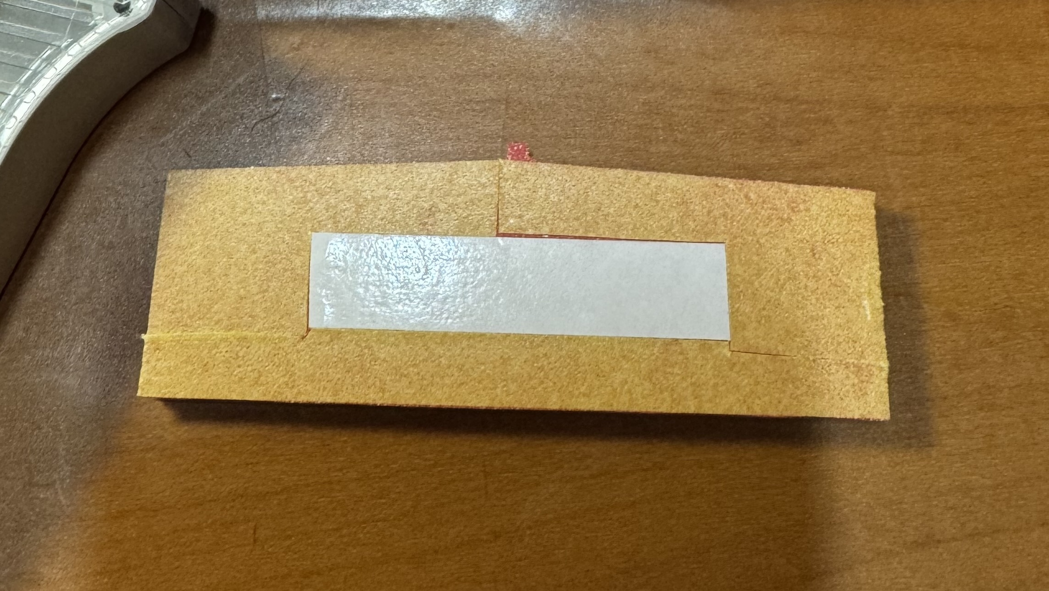
img/resevoir_back.jpeg
