kbinani/how-to-make-angel-ring-1/img/sanding_paper_holder.jpeg

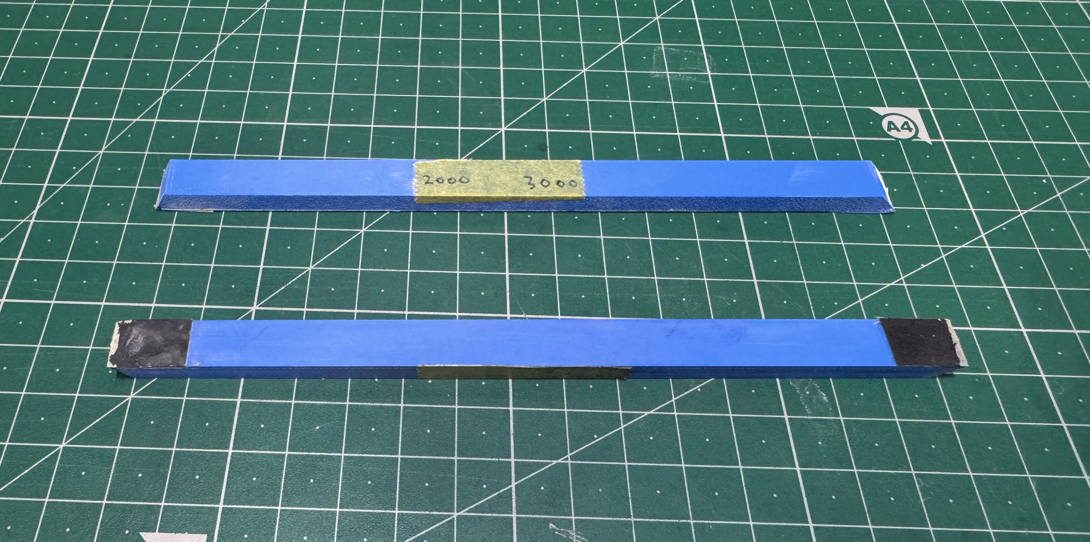
img/sanding_paper_holder.jpeg
