kbinani/how-to-make-angel-ring-1/attachment/sanding-paper-holder.stl

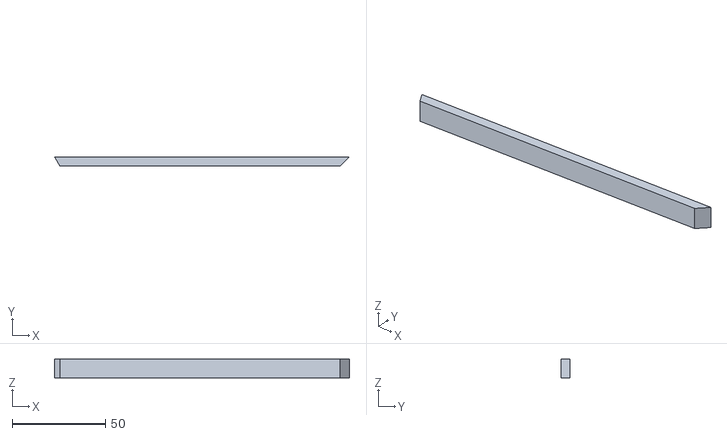
[picture p13: CAD file, 2026-10-15]
attachment/sanding-paper-holder.stl
157.9 x 5.00 x 10.0
