kbinani/how-to-make-angel-ring-1/attachment/prototype.stl

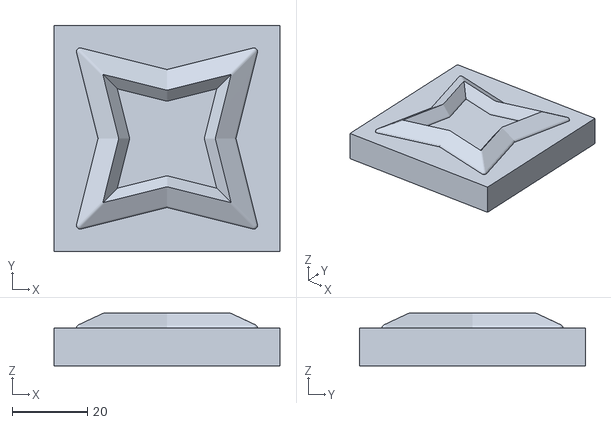
[picture p14: CAD file, 2026-10-14]
attachment/prototype.stl
60.0 x 60.0 x 14.0
