kbinani/how-to-make-angel-ring-1/attachment/mold-holder-resevoir-jig.stl

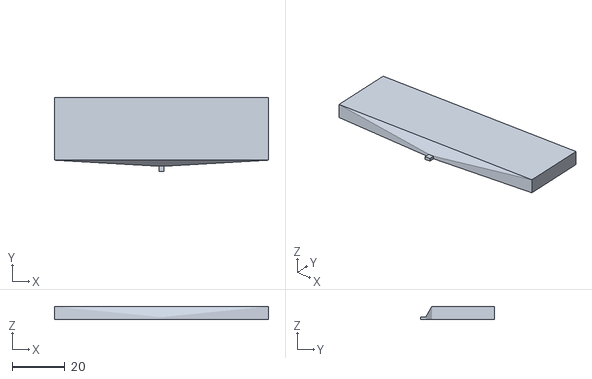
[picture p15: CAD file, 2026-10-13]
attachment/mold-holder-resevoir-jig.stl
81.2 x 28.1 x 5.00
