kbinani/how-to-make-angel-ring-1/attachment/mold-holder-frame.stl

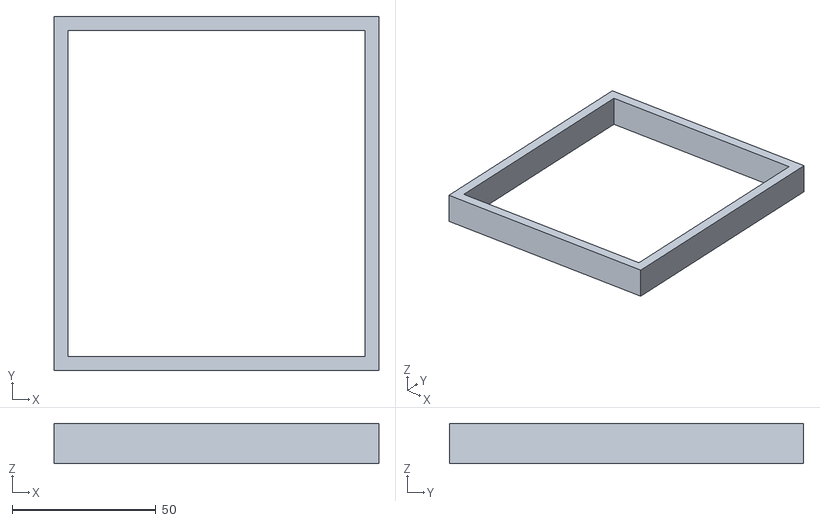
[picture p16: CAD file, 2026-10-13]
attachment/mold-holder-frame.stl
113.2 x 123.4 x 14.0
