kbinani/how-to-make-angel-ring-1/attachment/mold-holder-gasket-jig.stl

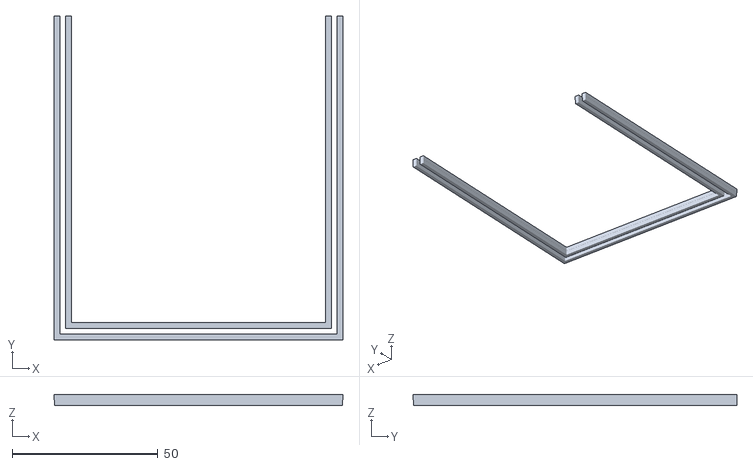
[picture p17: CAD file, 2026-10-13]
attachment/mold-holder-gasket-jig.stl
99.2 x 111.3 x 3.80
