kbinani/how-to-make-angel-ring-1/attachment/mold-holder.stl

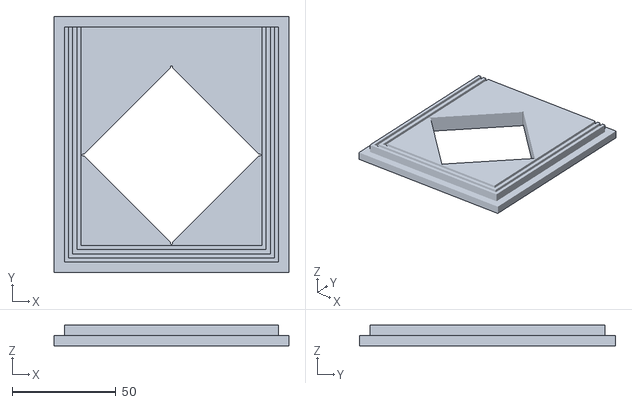
[picture p18: CAD file, 2026-10-13]
attachment/mold-holder.stl
113.2 x 123.4 x 10.1
