kbinani/how-to-make-angel-ring-1/attachment/mold-spacer.stl

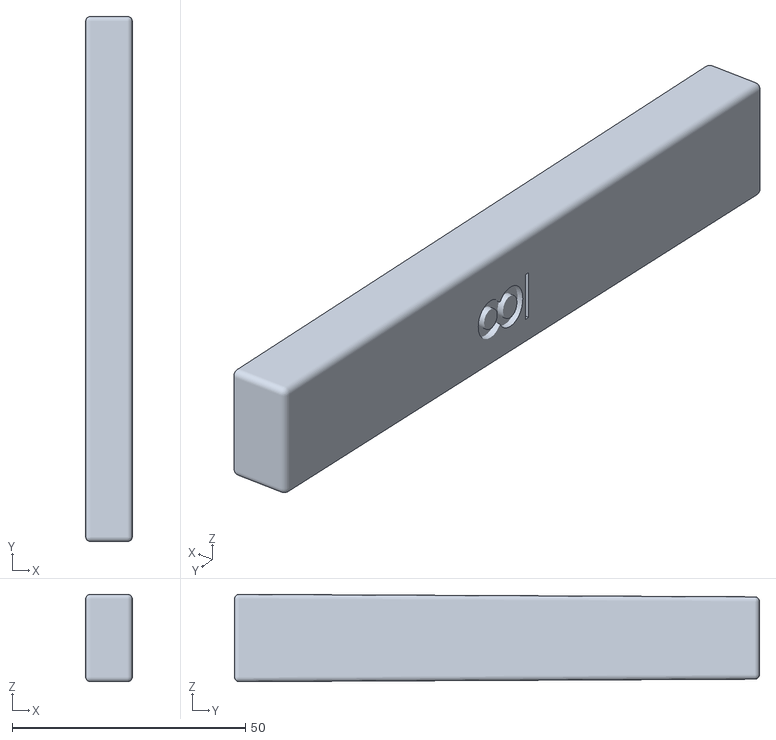
[picture p19: CAD file, 2026-10-12]
attachment/mold-spacer.stl
10.0 x 112.5 x 18.7
