kbinani/how-to-make-angel-ring-1/img/assembled_mold.jpeg

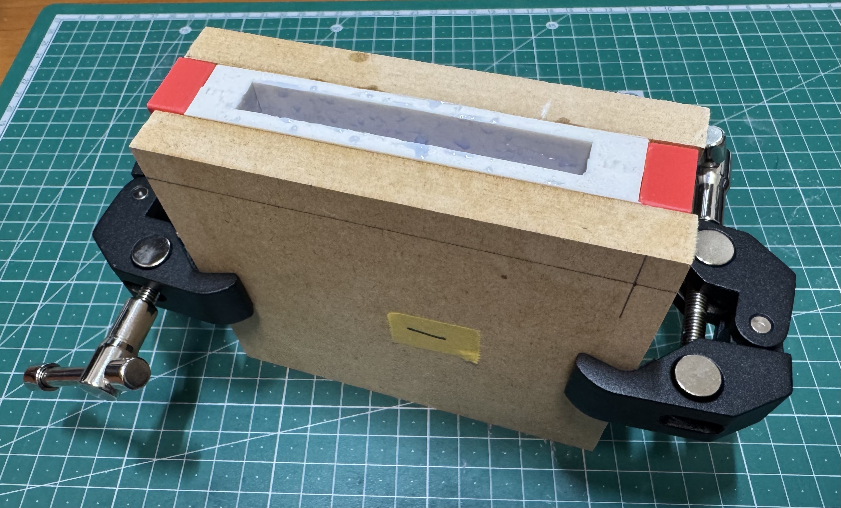
img/assembled_mold.jpeg
