kbinani/how-to-make-angel-ring-1/img/by-nc.pdf

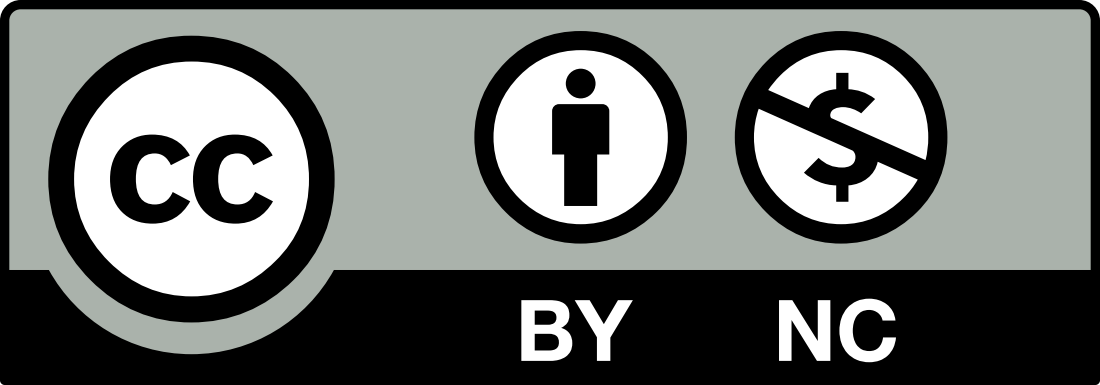
[picture p21: page 1]
