kbinani/how-to-make-angel-ring-1/(commit log)

2026-09-29 機材一覧と材料・消耗品一覧
2026-10-11 真空注型の section を追加
2026-10-11 「給気口」ではなく「プラグ」という表現に変更
2026-10-11 fix: 色素の量の指定には一応有効数字がある
2026-10-11 fix: 有効数字を一応考慮
2026-10-11 feat: 「調達」の chapter を追加
2026-10-11 cleanup: label の書式を変更
2026-10-11 feat: 「脱型と仕上げ」の section を追加
2026-10-11 fix: label:deforming の label を設置し忘れている
2026-10-11 fix: 「大気圧まで」との表現が重複している
2026-10-11 fix: typo を修正
2026-10-11 fix: 操作の目的の説明が手順の一覧の中に入っているのはおかしい
2026-10-11 fix: 真空槽の底には穴は空いていない
2026-10-11 feat: パッキンを清掃する手順を追記
2026-10-11 feat: 余白の量を変更
2026-10-11 feat: クランプした型のことを「型一式」と表現して「型」と区別する
2026-10-11 fix: 二種類の注射針を使っていてどちらの事を言っているのか分かりづらい
2026-10-11 feat: 沸騰槽の説明へのリンクを貼れるようにしておく
2026-10-11 feat: 「第n章 タイトル」を「n. タイトル」に変更
2026-10-12 feat: ファイルを添付する仕組みを用意
2026-10-12 feat: 「スペーサ」の section を追加
    [mold-spacer.stl]
2026-10-12 feat: 静置する場所の要件を追加
2026-10-12 feat: 「押さえ板」の section を追加
2026-10-12 fix: 「沸騰槽」へのリンクが初出の行に設定されていない
2026-10-12 feat: 調達品リストを更新
2026-10-12 feat: リンクの色を変更
2026-10-12 fix: 添付するファイルは全て ./attachment/ に置くことにする
2026-10-12 feat: 「キャピラリ」の section を追加
2026-10-12 feat: キャピラリの画像を掲載
2026-10-12 chore: .DS_Store と *.atfi を無視する
2026-10-12 feat: キャピラリを用いる目的の説明を調節
2026-10-12 feat: 文言を微調節
2026-10-12 feat: 表紙に図を掲載
2026-10-13 feat: 「型」の section を追加
2026-10-13 fix: 調達リストの「エポキシ樹脂」が重複している
2026-10-13 feat: 図を追加
2026-10-13 feat: 「原型ホルダ」の section を追加
    [mold-holder.stl]
2026-10-13 fix: 「エポキシ樹脂」へのリンクがリンク切れになっている
2026-10-13 feat: 「パッキン溝造形用治具」の section を追加
    [mold-holder-gasket-jig.stl]
2026-10-13 feat: 「沸騰槽造形用治具」と「枠」の section を追加
    [mold-holder-frame.stl, mold-holder-resevoir-jig.stl]
2026-10-13 feat: 気泡除去の様子を図で示す
2026-10-13 fix: 使用した両面テープが別のものだった
2026-10-13 fix: 硬化剤の量を具体的に
2026-10-13 fix: セクション内の初出位置にリンクを貼る
2026-10-13 fix: 直径の書き表し方を変更
2026-10-13 feat: 気泡の除去を行う理由と代替方法について追記
2026-10-13 fix: 下敷きが枠からずれ落ちたことはない。作業台を汚したことはある
2026-10-13 feat: 原型ホルダの仕上げについて追記
2026-10-13 feat: 型のバリ取りについてノウハウを追記
2026-10-13 feat: バルブの開閉について全開/全閉という表現に変更
2026-10-14 feat: 型各部の名称についての図を追加
2026-10-14 feat: スペーサのサイズを具体的に
2026-10-14 feat: 脱泡処理を行わなかった場合の失敗例を図示
2026-10-14 fix: 製品ではなく作品と表現する
2026-10-14 feat: 「原型」の section を仮作成
    [prototype.stl]
2026-10-15 chore: glossaries と uplatex が相性悪いので lualatex に切り替え
2026-10-15 feat: glossaries の機能で「調達」 chapter の中身を作る
2026-10-15 feat: 原型の制作手順を追加
2026-10-15 feat: 「耐水ペーパーホルダ」の section を追加
    [sanding-paper-holder.stl]
2026-10-15 cleanup: 備考欄は使ってない
2026-10-15 feat: 「はじめに」の chapter の中身を追加
2026-10-15 feat: 「ランナー部」の単語が唐突
2026-10-15 feat: 型の組み立て後の様子を図示
2026-10-15 feat: 原型の研磨について詳細に
2026-10-15 fix: 「再現性」の形容方法を統一
2026-10-15 fix: 「（図」のカッコが場所ごとに違っている
2026-10-15 fix: 過去形に統一
2026-10-15 feat: 耐水ペーパーホルダについて詳しく
2026-10-15 cleanup: 長音を省略するかしないか整理
2026-10-15 feat: 「Q&A」の chapter を追加
2026-10-16 cleanup: QA のスタイルを調節
2026-10-16 feat: タイトルを変更
2026-10-16 feat: レジンプリンタの設定を具体的に
2026-10-16 feat: 著作権情報を表示
2026-10-16 feat: 「落し蓋」を「中敷き」に変更
2026-10-16 feat: 「中敷き」の配置例を図示
2026-10-16 feat: 沸騰槽造形用治具の裏面の様子を図示
2026-10-16 fix: 先に枠を取り付けないと沸騰槽造形用治具の位置が決まらない
2026-10-16 feat: 表紙の図の説明を追加ほか
2026-10-16 feat: メーカーと型番を明示
2026-10-16 fix: 表紙の図は脱型直前ではなく脱型最中の図
2026-10-16 feat: 耐水ペーパーホルダーの様子を図示
2026-10-17 feat: 免責事項を掲載
2026-10-17 feat: リビジョン番号を付ける
2026-10-17 feat: サムネイルを生成するスクリプトを準備
2026-10-17 chore: リビジョン番号を 2 に
2026-10-17 cleanup: user2 ではなく description を使う
2026-10-17 feat: 「中敷き」と「下敷き」が分かりにくいので下敷きの方をプラスチック板と言い換える
2026-10-17 feat: \chklink を \link に変更
2026-10-17 feat: CC-NC のアイコンは pdf に変換したものを使う
2026-10-17 feat: 文言を調節
2026-10-17 feat: 使用しているガスマスクも紹介する
2026-10-17 feat: 注射針の操作や針の選び方を具体的に
2026-10-17 fix: 作業台一式を硬化させると言っているように見える
2026-10-18 feat: -0.7bar から大気圧まで戻す操作は実測したら 2 分程度時間をかけていた
2026-10-18 feat: なるべく 1 行 1 文にする
2026-10-22 fix: 油性マジックを消すのではない
2026-10-22 fix: 原型ホルダーより原型の方が凸形状だから削りやすい
2026-10-22 feat: シリコーンは作業中も硬化が進むので注意が必要
2026-10-22 chore: LICENSE ファイルを追加
    - curl -L https://creativecommons.org/licenses/by-nc/4.0/legalcode.txt -o LICENSE
2026-10-25 feat: 準備する樹脂の量はもう少し減らせる
2026-10-25 cleanup: 持ち方は何でもいい
2026-11-05 feat: メーカー公式ページからだとセットじゃなく単品で購入できる
2026-11-05 feat: 上段に置く型は下面を下にして組み立てた方が安定する
